antonTan96/r2auto_nav_CDE2310/mech_doc/3dprinting/README.md

# ICBM Launch Printing Info

This document provides detailed instructions for printing

---

## Printing Instructions

### Self-Printing
- Open the files in Bambu Studio(Recommended) or any preferred slicing software
- Support structures and print types have been optimised
- Make sure to change the filament settings based on your preferred type of filament to use

### Printing with iDP
- **Not reccommended**: Too expensive to print all in one piece
- Smaller sub parts are provided for tweaks and testing
