antonTan96/r2auto_nav_CDE2310/elec_doc/Electrical diagram and Electronics system architecture.pdf

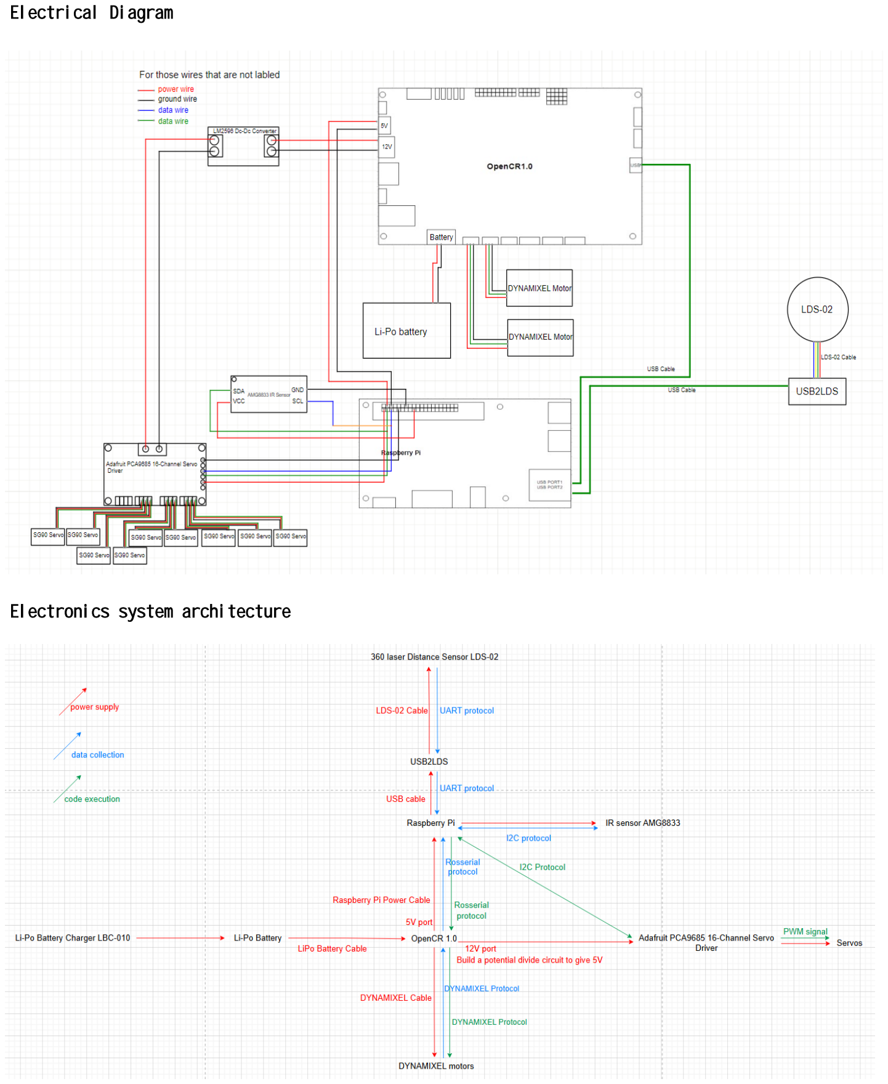
[picture p2: page 1]

Electrical Diagram

Electronics system architecture
