antonTan96/r2auto_nav_CDE2310/general_doc/media/photo_2025-03-25_21-10-47.jpg

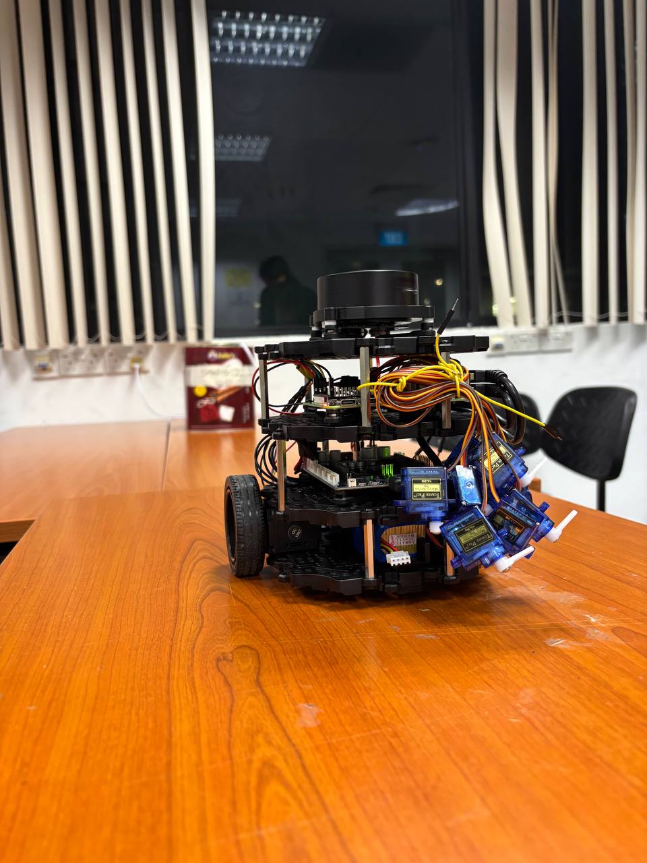
general_doc/media/photo_2025-03-25_21-10-47.jpg
