antonTan96/r2auto_nav_CDE2310/general_doc/media/Picture of the bot (4).jpg

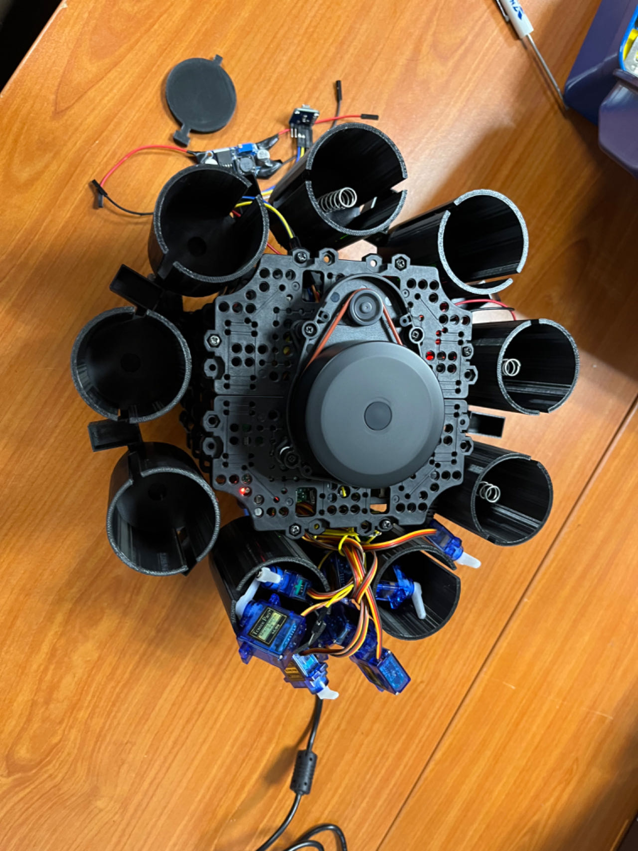
general_doc/media/Picture of the bot (4).jpg
