antonTan96/r2auto_nav_CDE2310/general_doc/media/Picture of the final bot.jpg

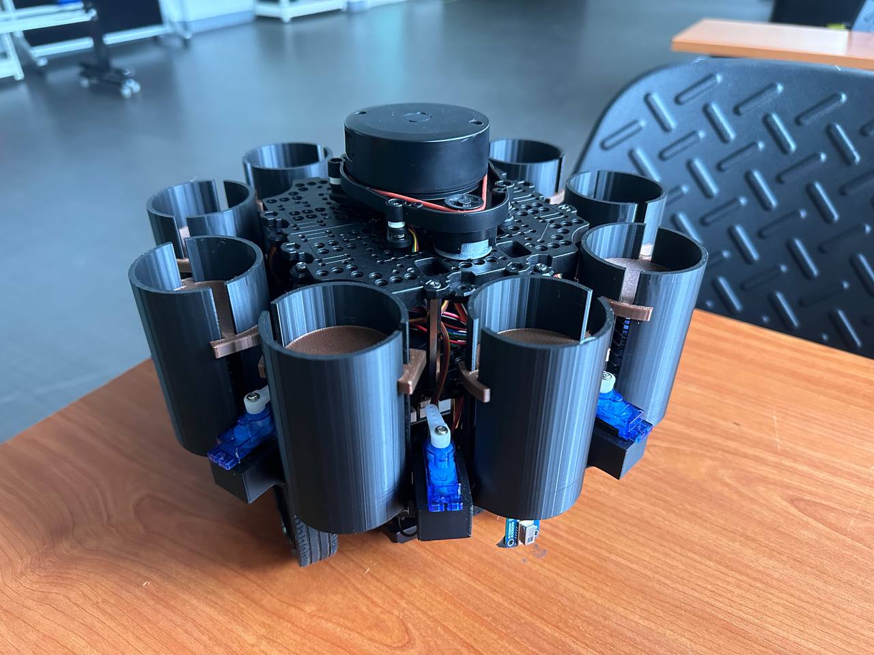
general_doc/media/Picture of the final bot.jpg
