antonTan96/r2auto_nav_CDE2310/general_doc/Budget Breakdown.xlsx

No. | Part | Quantity | Unit Price | Payment
1 | PCA9685 | 1 | 4.03 | 4.03
2 | LM2596 | 1 | 1.25 | 1.25
3 | SG90 Servo | 9 | 3 | 27
4 | ALT TAB PLA 300g Filament | 1 | $4.90 | $4.90
5 | AMG8833 | 1 | 27.9 | 27.9
6 | Spring | 9 | 0.3 | 2.7
Total |  |  |  | 67.78
Budget |  |  |  | 80
Remaining |  |  |  | 12.22
