antonTan96/r2auto_nav_CDE2310/mech_doc/CAD Files/Waffle Plate.SLDPRT

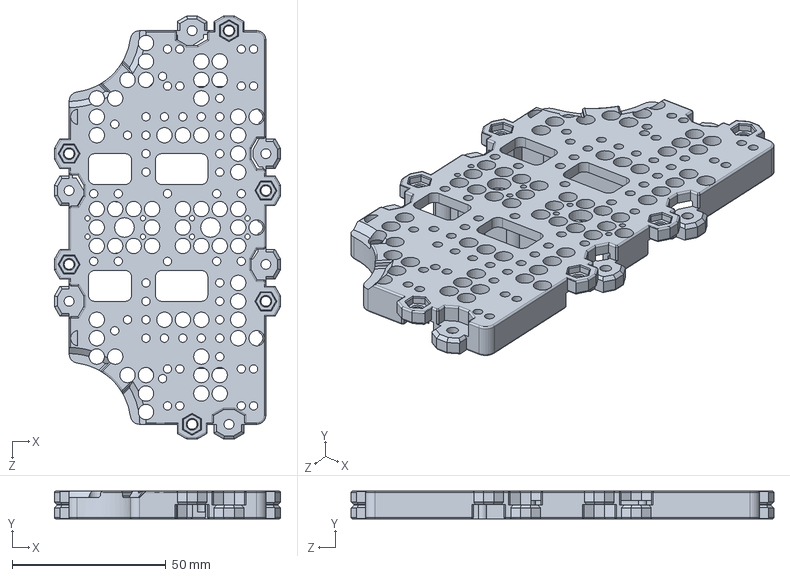
[picture p9: CAD file, 2025-04-18]
mech_doc/CAD Files/Waffle Plate.SLDPRT
73.5 x 9.00 x 137.5 mm
