antonTan96/r2auto_nav_CDE2310/mech_doc/CAD Files/ICBM Tube.SLDPRT

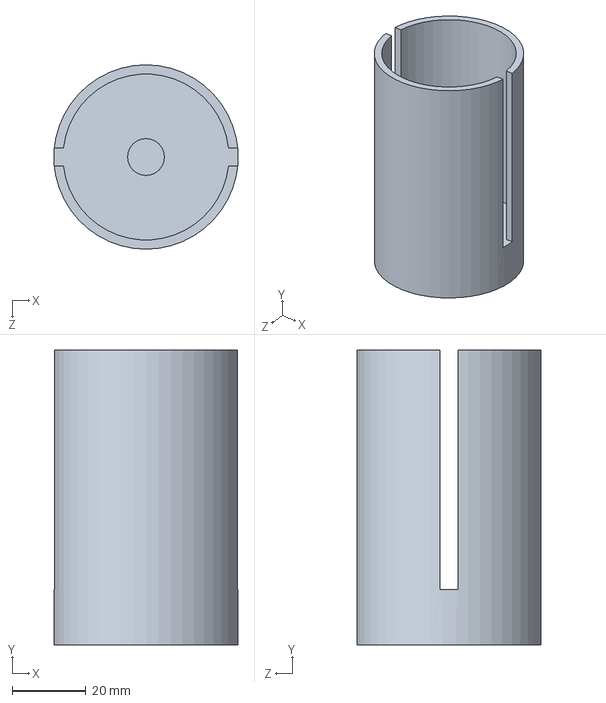
[picture p10: CAD file, 2025-04-18]
mech_doc/CAD Files/ICBM Tube.SLDPRT
49.9 x 80.0 x 50.0 mm
