antonTan96/r2auto_nav_CDE2310/mech_doc/CAD Files/Launch Tube.SLDPRT

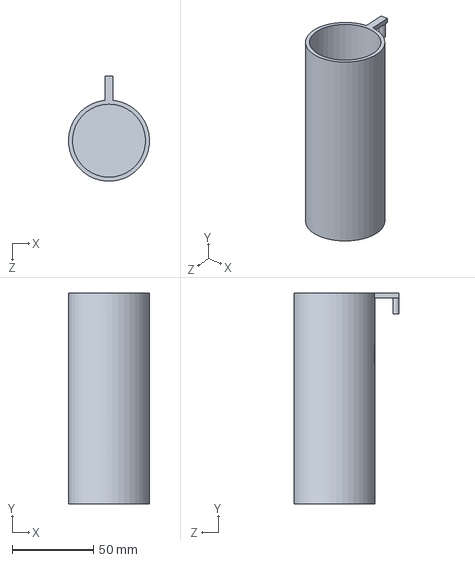
[picture p11: CAD file, 2025-04-18]
mech_doc/CAD Files/Launch Tube.SLDPRT
50.0 x 130.0 x 65.0 mm
