antonTan96/r2auto_nav_CDE2310/mech_doc/CAD Files/Lid.SLDPRT

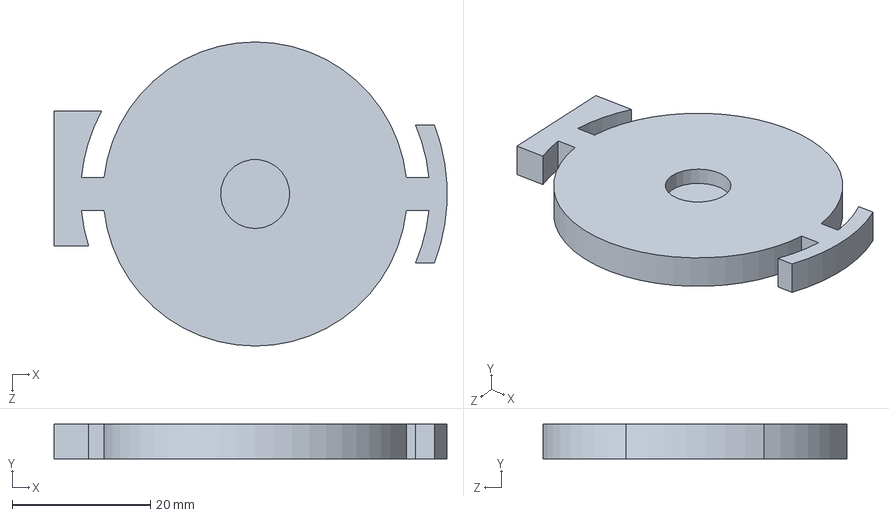
[picture p12: CAD file, 2025-04-18]
mech_doc/CAD Files/Lid.SLDPRT
56.9 x 5.00 x 44.0 mm
