antonTan96/r2auto_nav_CDE2310/mech_doc/CAD Files/Spring.SLDPRT

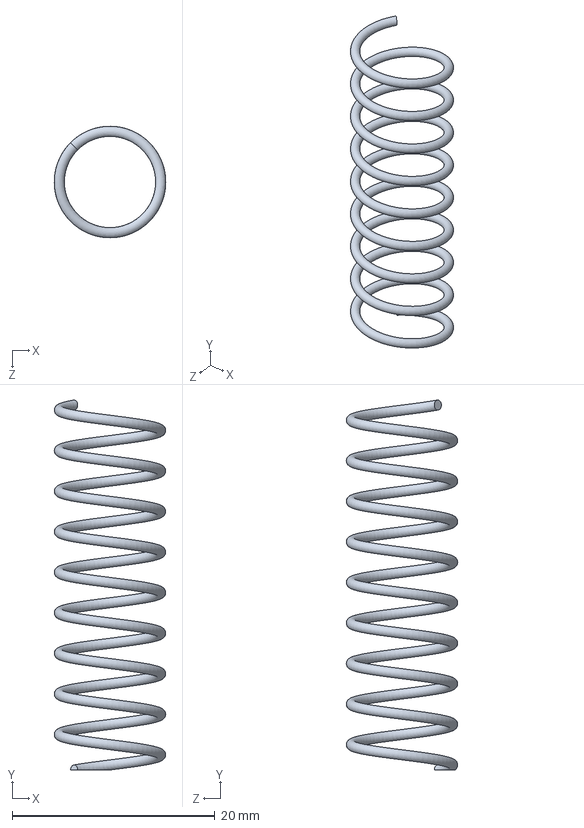
[picture p13: CAD file, 2025-04-18]
mech_doc/CAD Files/Spring.SLDPRT
11.0 x 36.5 x 11.0 mm
