antonTan96/r2auto_nav_CDE2310/mech_doc/CAD Files/ICBM.SLDPRT

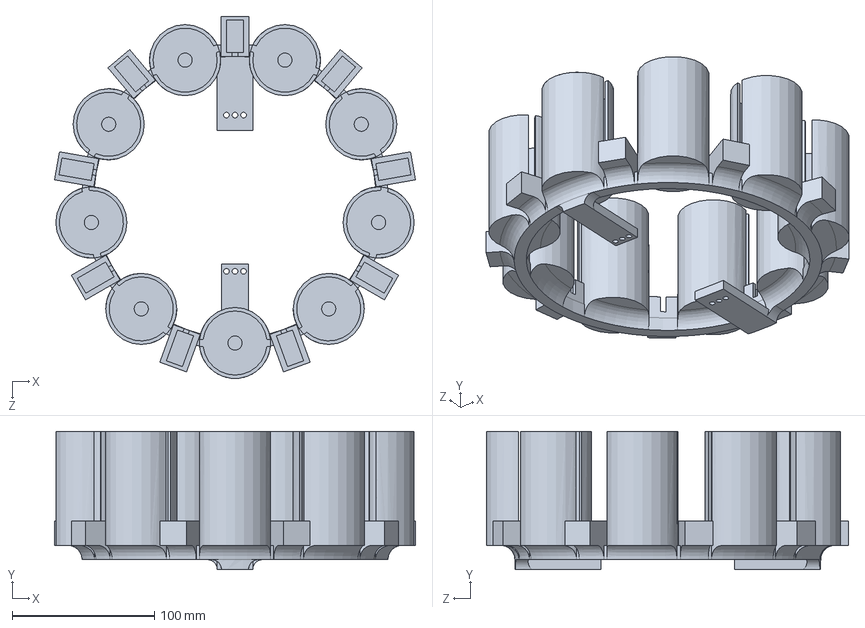
[picture p14: CAD file, 2025-04-18]
mech_doc/CAD Files/ICBM.SLDPRT
253.6 x 97.0 x 254.5 mm
