antonTan96/r2auto_nav_CDE2310/mech_doc/CAD Files/Second Layer.SLDASM

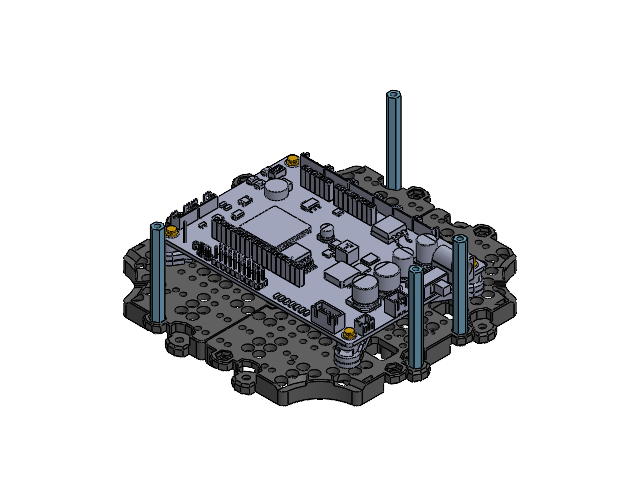
[picture p15: CAD file, 2025-04-18]
mech_doc/CAD Files/Second Layer.SLDASM
PHS_M2_5X12 x 4
SUPPORT_HEX_M3_0XL45_FF x 4
PR30_IBB_01_3D x 4
Waffle Plate x 2
pan head cross recess screw_iso x 4
PR07_ONE_RIVET_2.step x 4
