antonTan96/r2auto_nav_CDE2310/mech_doc/CAD Files/First Layer.SLDASM

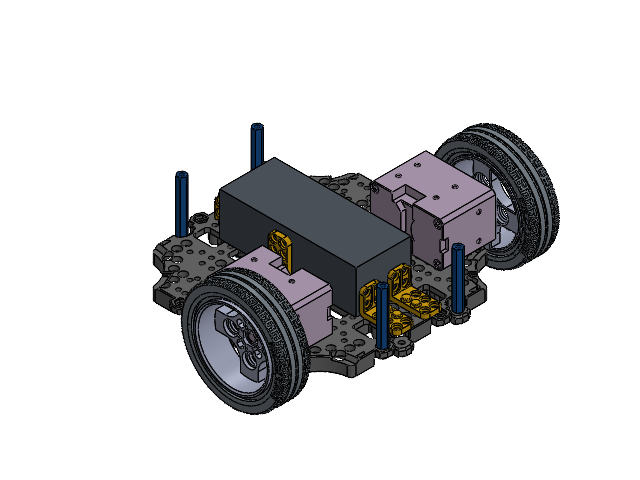
[picture p16: CAD file, 2025-04-18]
mech_doc/CAD Files/First Layer.SLDASM
Waffle Plate x 2
pan head cross recess screw_iso x 16
NUT2_M3.step x 4
STEELBALL_3_8INCH
PR21_CASTER_CVR_3X5_REV6
pan cross head_ks x 12
SUPPORT_HEX_M3_0XL35_FF.step x 4
M_PR07_A01_BRACKET_2 x 5
PR07_ONE_RIVET_2.step x 10
LB-012.step
PR16_A01_TIRE_2-1 x 2
P30_ISP_A001_3D x 2
XM430.step x 2
