antonTan96/r2auto_nav_CDE2310/mech_doc/CAD Files/Forth Layer.SLDASM

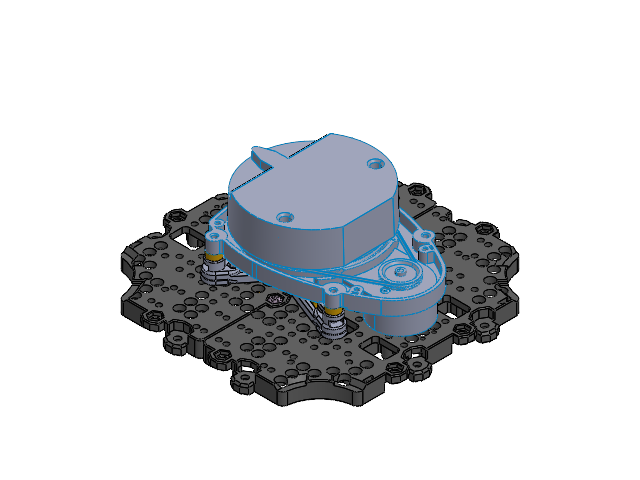
[picture p17: CAD file, 2025-04-18]
mech_doc/CAD Files/Forth Layer.SLDASM
LDS_ONSHAPE
NUT2_M3-1 x 4
PHS_M3X6-1 x 4
PHS_M2_5X12-2 x 4
PR30_IBB_01_3D-2 x 4
M_PR07_A01_SPACER_RIVET x 4
Waffle Plate x 2
