antonTan96/r2auto_nav_CDE2310/mech_doc/CAD Files/OPENCR.SLDASM

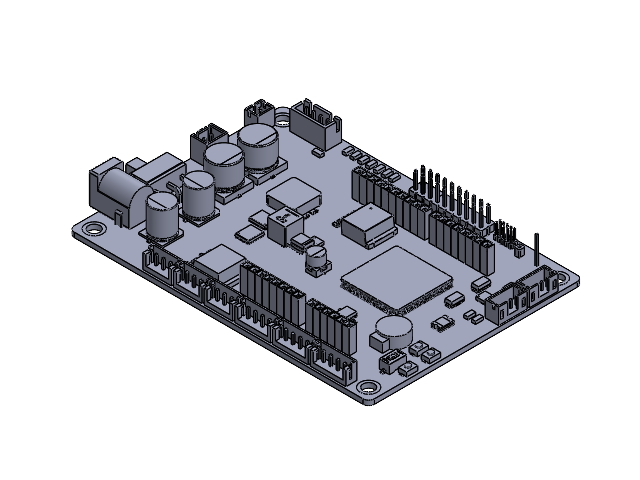
[picture p18: CAD file, 2025-04-18]
mech_doc/CAD Files/OPENCR.SLDASM
MANIFOLD_SOLID_BREP_33058
MANIFOLD_SOLID_BREP_33044
SAR1
MANIFOLD_SOLID_BREP_33075
MANIFOLD_SOLID_BREP_33078
PIN-33295
MANIFOLD_SOLID_BREP_33100
USER_LIBRARY-8-VSON_5X6_U-33204
MANIFOLD_SOLID_BREP_33053
MANIFOLD_SOLID_BREP_33094
PIN-33293
PINN-33307
MANIFOLD_SOLID_BREP_33081
MANIFOLD_SOLID_BREP_33061
IMPORTED1-33207
MANIFOLD_SOLID_BREP_33152
MANIFOLD_SOLID_BREP_33192
MANIFOLD_SOLID_BREP_33161
MANIFOLD_SOLID_BREP_33083
50MIL_HEADER_BODY-33294
MANIFOLD_SOLID_BREP_33261
MANIFOLD_SOLID_BREP_33066
MANIFOLD_SOLID_BREP_33256
MANIFOLD_SOLID_BREP_33086
MANIFOLD_SOLID_BREP_33063
MANIFOLD_SOLID_BREP_33073
MANIFOLD_SOLID_BREP_33062
MANIFOLD_SOLID_BREP_33087
PIN_HEADER_DOUBLE_ROW-_20_CONTA
USER_LIBRARY-8-VSON_5X6_U-33109
50MIL_HEADER_BODY-33289
MANIFOLD_SOLID_BREP_33092
MANIFOLD_SOLID_BREP_33060
MANIFOLD_SOLID_BREP_33253
MANIFOLD_SOLID_BREP_33163
50MIL_HEADER_BODY-33251
50MIL_HEADER_BODY-33149
MANIFOLD_SOLID_BREP_33045
MANIFOLD_SOLID_BREP_33071
MANIFOLD_SOLID_BREP_33055
MANIFOLD_SOLID_BREP_33056
MANIFOLD_SOLID_BREP_33046
MANIFOLD_SOLID_BREP_33064
USER_LIBRARY-WE-DD-L_PIN_-33128
MANIFOLD_SOLID_BREP_33096
USER_LIBRARY-8-VSON_5X6_U-33219
MANIFOLD_SOLID_BREP_33122
MANIFOLD_SOLID_BREP_33114
MANIFOLD_SOLID_BREP_33129
PIN-33249
MANIFOLD_SOLID_BREP_33230
MANIFOLD_SOLID_BREP_33157
MANIFOLD_SOLID_BREP_33085
MANIFOLD_SOLID_BREP_33097
USER_LIBRARY-8-VSON_5X6_U-33106
MANIFOLD_SOLID_BREP_33184
MANIFOLD_SOLID_BREP_33279
MANIFOLD_SOLID_BREP_33172
MANIFOLD_SOLID_BREP_33103
MANIFOLD_SOLID_BREP_33260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
