antonTan96/r2auto_nav_CDE2310/mech_doc/CAD Files/Connected Plates.SLDASM

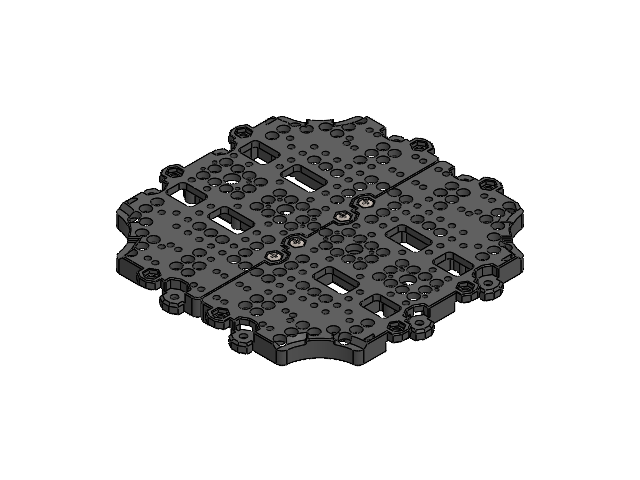
[picture p19: CAD file, 2025-04-18]
mech_doc/CAD Files/Connected Plates.SLDASM
Waffle Plate x 2
pan head cross recess screw_iso x 4
NUT2_M3.step x 4
