antonTan96/r2auto_nav_CDE2310/(list of files, cad)

Other CAD files:
mech_doc/3dprinting/Lid.gcode.3mf
mech_doc/3dprinting/ICBM Tube.STL
mech_doc/3dprinting/ICBM.3mf
mech_doc/3dprinting/ICBM.STL
mech_doc/3dprinting/Lid.3mf
mech_doc/3dprinting/Lid.STL
mech_doc/ICBM Drawing.SLDDRW
mech_doc/Lid Drawing.SLDDRW
