antonTan96/r2auto_nav_CDE2310/(commit log)

2025-03-25 Add files via upload
    I2C Functionality Complete
2025-04-17 Add flow chart diagrams
2025-04-18 I am tired
2025-04-18 Create cad README.md
2025-04-18 Create printing README
2025-04-18 Create printing README.md
2025-04-18 Update printing README.md
2025-04-18 Update cad README.md
2025-04-23 Rename printing README.md to README.md
